Necro-Fantasy/STM32F103C8T6_BUCK_Converter/docs/BUCK-BOM.xlsx

位号 | 数量 | 名称 | 参数 | 型号/MPN | 封装 | 厂家/品牌
C6 | 1 | 铝电解电容 | 330uF | EEEFT1H331GP | SMD_10*10.3 | PANASONIC
C9 | 1 | 贴片电容 | 0.1uF | / | SMD_C0805 | Your Cee
U4 | 1 | 降压芯片 | 12V输入5V输出 | LM2596S-5.0 | TO-263-5 | UMW
D2 | 1 | 肖特基二极管 | 5A / 60V | SS56A | SMD_SS56A | FUXINSEMI
U3 | 1 | 功率电感 | 150uH | CDRH125L125NP-151MC | SMD_12*12 | Sumida
C7 | 1 | 铝电解电容 | 330uF | EEEFT1H331GP | SMD_10*10.3 | PANASONIC
C10 | 1 | 贴片电容 | 0.1uF | / | SMD_C0805 | Your Cee
SW1 | 1 | 按键开关 | / | XKB8080-Z | SW_TH-6P 8*8*2.5 | XKB Enterprise
R13 | 1 | 贴片电阻 | 5K | / | SMD_R0805 | ROYAL
LED4 | 1 | LED | / | 204-10SDRD | TH_LED3.0_Green | EVERLIGHT
OLED | 1 | OLED屏幕 | / | 0.96OLED_4P | TH_0.96OLED_4P | Your Cee
RLY1 | 1 | 继电器 | / | SRD-05VDC-SL-C | TH_RELAY | SONGLE
P1 | 1 | 直针座 | / | WJ500V-5.08-3P | TH_3Pin | KANGNEX
D1 | 1 | 二极管 | 100V / 150mA | 1N4148 | TH_DO-35 | STMicroelectronics
R7 | 1 | 贴片电阻 | 1K | / | SMD_R0805 | ROYAL
LED1 | 1 | LED | / | 204-10SDRD | TH_LED3.0_Red | EVERLIGHT
R8 | 1 | 贴片电阻 | 1K | / | SMD_R0805 | ROYAL
Q3 | 1 | 三极管 | / | S9013 | TO-92 | Your Cee
R14 | 1 | 贴片电阻 | 1K | / | SMD_R0805 | ROYAL
R15 | 1 | 贴片电阻 | 1K | / | SMD_R0805 | ROYAL
D6 | 1 | 二极管 | 1A/1000V | RS1M | SMD_SMA | Agertech
U5 | 1 | 驱动芯片 | / | IR2104STRPBF | SMD_SOCI-8 | IR
C12 | 1 | 独石电容 | 2.2uF | / | TH_5*2.5*5.08 | Your Cee
CN3 | 1 | 直针座 | / | XH-4A | TH-4Pin | HCTL
R33 | 1 | 贴片电阻 | 10K | / | SMD_R0805 | ROYAL
R31 | 1 | 贴片电阻 | 10K | / | SMD_R0805 | ROYAL
R34 | 1 | 贴片电阻 | 1K | / | SMD_R0805 | ROYAL
R32 | 1 | 贴片电阻 | 1K | / | SMD_R0805 | ROYAL
U18 | 1 | 电压采样芯片 | / | OPA2188 | SOP-8 | SOWO
C38 | 1 | 贴片电容 | 2.2uF | / | SMD_C0805 | Your Cee
C39 | 1 | 贴片电容 | 2.2uF | / | SMD_C0805 | Your Cee
D15 | 1 | 二极管 | 100V / 150mA | 1N4148 | TH_DO-35 | STMicroelectronics
R4 | 1 | 采样电阻 | 10mΩ | / | SMD_R1206 | ROYAL
R2 | 1 | 贴片电阻 | 9R1 | / | SMD_R0805 | ROYAL
R3 | 1 | 贴片电阻 | 9R1 | / | SMD_R0805 | ROYAL
C1 | 1 | 贴片电容 | 1nF | / | SMD_C0805 | Your Cee
U2 | 1 | 电流采样芯片 | / | INA213AIDCKR | TSSOP_6 | TI
C2 | 1 | 贴片电容 | 10nF | / | SMD_C0805 | Your Cee
C3 | 1 | 贴片电容 | 100nF | / | SMD_C0805 | Your Cee
D3 | 1 | 二极管 | 100V / 150mA | 1N4148 | TH_DO-35 | STMicroelectronics
CN1 | 1 | 直针座 | / | XH-4A | TH-4Pin | HCTL
U1 | 1 | 直针座 | / | KF7.62-2P | TH_2Pin | Cixi Kefa Elec
C8 | 1 | 贴片电容 | 100nF | / | SMD_C0805 | Your Cee
C14 | 1 | 电解电容 | 220uF | / | TH_ECAP_D10_P5 | CX
C13 | 1 | 电解电容 | 220uF | / | TH_ECAP_D10_P5 | CX
R5 | 1 | 贴片电阻 | 10k | / | SMD_R0805 | ROYAL
R6 | 1 | 贴片电阻 | 10 | / | SMD_R0805 | ROYAL
D5 | 1 | 二极管 | 100V / 150mA | 1N4148 | TH_DO-35 | STMicroelectronics
Q2 | 1 | NMOS | / | IRF3205ZPBF | TO-220-3 | Infineon
Q1 | 1 | NMOS | / | IRF3205ZPBF | TO-220-3 | Infineon
D4 | 1 | 二极管 | 100V / 150mA | 1N4148 | TH_DO-35 | STMicroelectronics
R10 | 1 | 贴片电阻 | 10 | / | SMD_R0805 | ROYAL
R11 | 1 | 贴片电阻 | 10k | / | SMD_R0805 | ROYAL
C4 | 1 | 电解电容 | 220uF | / | TH_ECAP_D10_P5 | CX
C11 | 1 | 电解电容 | 220uF | / | TH_ECAP_D10_P5 | CX
C5 | 1 | 贴片电容 | 100nF | / | SMD_C0805 | Your Cee
L1 | 1 | 功率电感 | 470uH | / | / | 滨江电子
R12 | 1 | 贴片电阻 | 0 | / | SMD_R0805 | ROYAL
U6 | 1 | 直针座 | / | KF7.62-2P | TH_2Pin | Cixi Kefa Elec
TP1 | 1 | M3铜柱 | / | / | / | Your Cee
TP2 | 1 | M3铜柱 | / | / | / | Your Cee
TP3 | 1 | M3铜柱 | / | / | / | Your Cee
TP4 | 1 | M3铜柱 | / | / | / | Your Cee
DEC1 | 1 | 按键 | / | / | SMD_6*6*5 | ReliaPro
ZENG1 | 1 | 按键 | / | / | SMD_6*6*6 | ReliaPro
FAN1 | 1 | 按键 | / | / | SMD_6*6*7 | ReliaPro
PAUSE1 | 1 | 按键 | / | / | SMD_6*6*8 | ReliaPro
DC1 | 1 | DC 电源插座 | DC-005 | DC-005-A-2.0 | TH_DC-005 | XKB Enterprise
