Necro-Fantasy/STM32F103C8T6_BUCK_Converter/docs/BUCK_Checklist.xlsx

Sheet: 00_统一测试标准
BUCK 项目统一测试标准
测试类别 | 适用阶段 | 允许工具 | 统一合格标准 | 禁止动作 | 备注
A. 外观检查 | 每个模块焊后 | 肉眼/手机放大/放大镜 | 无连锡、无虚焊、极性/方向与丝印一致 | 不确定方向时禁止上电 | IC、二极管、电解电容、排针方向优先检查
B. 断电短路检查 | 每个模块焊后、上电前 | 万用表蜂鸣档/电阻档 | 电源轨对地不持续短路；关键引脚之间不硬短 | 蜂鸣不查原因禁止上电 | 电容充电导致短叫一下可接受，持续蜂鸣不可接受
C. 低风险上电 | 断电检查通过后 | 可调电源/适配器 + 万用表 | 无冒烟、无异味、芯片不快速发热；电源不明显掉压 | 无真限流电源时禁止反复短路试错 | 若有实验电源，优先限流；无则短时上电并立即测电压
D. DC 电压检查 | 低风险上电后 | 万用表 | +5V: 4.80–5.20V；+3.3V: 3.20–3.40V；逻辑脚不应悬空到异常电压 | 电压异常时禁止插 STM32/禁止接负载 | 先看静态 DC，再看波形
E. 低速逻辑检查 | STM32 已插且程序可控后 | 万用表/示波器低速测 | IN、SD、EN 等逻辑电平与程序预期一致 | 未插 STM32 时禁止判断 IR2104 动态功能 | IR2104 的 HO/LO 需要有 IN/SD 才有判定意义
F. 示波器波形检查 | 接地弹簧到位后 | 示波器 x10 探头 + 短地弹簧 | 纹波/尖峰不超过模块标准；波形趋势符合拓扑 | 长地线测高速点后禁止据此判故障 | 没有接地弹簧时，只做慢速/低频判断
G. 功率测试 | 前级全部通过后 | 负载/电源/示波器/万用表 | 逐步升占空比/逐步加负载；无过热、无异常尖峰 | 禁止直接满占空比、禁止直接接大负载 | 主 Buck 最后做，先开环小占空比
备注 / 使用说明
这个工作簿不是公司级标准，而是适用于当前 STM32 + IR2104 + Buck 项目的个人工程标准。
门禁原则：没有通过断电检查，不上电；没有通过低压/静态检查，不插核心板；没有接地弹簧，不严肃判高速纹波/振铃；主功率级最后启动。

Sheet: 01_模块总览
BUCK 项目模块拆分总览
模块编号 | 模块名称 | 主要位号/器件 | 前置条件 | 本阶段目标 | 通过后允许进入 | 当前建议状态
M1 | 供电模块 LM2596 | DC1, SW1, C6, C9, U4, D2, U3, C7, C10, LED4/R13 | 无 | 确认 +12V 输入到 +5V 辅助电源稳定 | STM32 接口静态检查 | 已基本通过；纹波待接地弹簧补测
M2 | STM32 核心板接口 | H2/H3 排针/排母, +5V, +3.3V, GPIO/PWM/ADC/OLED 引脚 | M1 通过 | 确认插座供电、方向、关键 IO 不短路 | 插入 STM32，跑最小程序 | 未完成/待焊
M3 | IR2104 驱动模块 | U5, Cboot, VCC 去耦, D6, R5/R6/R10/R11, D4/D5 | M1 通过；M2 提供 IN/SD | 确认 VCC-COM、VB-VS、LO/HO 驱动逻辑 | 主功率 MOS 静态检查 | 已焊；当前只能做静态检查
M4 | 主功率半桥 | Q1/Q2, 栅极网络, 主功率输入电容/端子 | M3 静态通过；PWM/SD 可控 | 确认 MOS 栅极不误导通、半桥无直通 | 电感/输出滤波接入 | 未启动，禁止开主功率
M5 | 输出滤波与负载端 | 主电感、输出电容、输出端子 | M4 通过 | 确认输出 LC 滤波、空载输出、纹波 | 电压/电流采样联调 | 待完成
M6 | 电压/电流采样 | R4 采样电阻, INA213, OPA2188, ADC 分压/滤波 | M1/M2 通过；输出端可控 | 确认采样值与万用表一致 | 闭环控制/保护 | 待完成
M7 | 保护继电器/关断链路 | RLY1, D1, Q3, LED1, R7/R8/R14/R15, SD/保护信号 | M2/M3 通过 | 确认保护动作能关断输出 | 带保护的低功率测试 | 可先静态焊小件
M8 | 人机交互与显示 | OLED, KEY, SW, 编码器/按键接口 | M1/M2 通过 | 确认显示、按键、参数调节 | 系统联调 | 待完成

Sheet: 02_供电模块_LM2596
M1 供电模块 LM2596 Checklist
步骤ID | 阶段 | 检查项 | 操作 | 工具 | 统一合格标准 | 状态 | 实测值/记录 | 门禁结论 | 备注
M1-01 | 外观 | C6/C7 电解方向 | 核对丝印、负极标记和焊点 | 目视/照片放大 | 极性正确，无连锡/虚焊 | 已通过 | / | 禁止继续 | C6 输入侧，C7 输出侧
M1-02 | 外观 | D2 方向 | 确认 SS56A 阴极/阳极与原理图一致 | 目视/二极管档 | 方向正确；D2 为续流二极管 | 已通过 | / | 禁止继续 | D2 不是防反接，是关断续流
M1-03 | 断电 | +12V 对 DGND | 万用表蜂鸣/电阻测 +12V 到 DGND | 万用表 | 不持续短路 | 已通过 | 1.73V | 禁止继续 | 电容充电短叫可接受
M1-04 | 断电 | +5V 对 DGND | 万用表蜂鸣/电阻测 +5V 到 DGND | 万用表 | 不持续短路 | 已通过 | 1.64V | 禁止继续
M1-05 | 上电 | 12V 输入启动 | 短时上电观察 | 电源/万用表 | 不冒烟、不异味、不快速发热 | 已通过 | / | 禁止继续 | 无真限流电源时不要反复短路试错
M1-06 | DC | +5V 输出 | 测 +5V 到 DGND | 万用表 | 4.80–5.20V | 已通过 | 5.1V | 禁止继续
M1-07 | 启动 | 启动过冲 | Single 触发测 +5V 上升过程 | 示波器 | 无 >5.5V 有效过冲 | 已通过 |  | 禁止继续 | 已低通/限带判断通过
M1-08 | 纹波 | +5V 空载纹波 | 短地弹簧测 C7 两端 | 示波器 x10 | 目标 <50mVpp；<100mVpp 暂可接受 | 已通过 | Pk-Pk 84.19mV | 禁止继续
M1-09 | 热 | 空载 5 分钟 | 12V 空载运行 5 分钟 | 手感/测温 | 无明显发烫 | 已通过 | / | 禁止继续

Sheet: 03_STM32接口模块
M2 STM32 核心板接口 Checklist
步骤ID | 阶段 | 检查项 | 操作 | 工具 | 统一合格标准 | 状态 | 实测值/记录 | 门禁结论 | 备注
M2-01 | 外观 | STM32 排针/排母方向 | 确认排母位置、方向、焊点 | 目视/照片放大 | 方向正确，无连锡 | 已通过 | / | 禁止继续 | 核心板本体建议最后插
M2-02 | 断电 | +5V 对 DGND | 不插 STM32，测核心板座 +5V 到地 | 万用表 | 不持续短路 | 已通过 | 0.689V | 禁止继续
M2-03 | 断电 | +3.3V 对 DGND | 不插 STM32，测 +3.3V 到地 | 万用表 | 不持续短路 | 已通过 | 0.945V | 禁止继续 | 若 3.3V 由核心板提供，未插时可能无电
M2-04 | 上电 | 不插 STM32 测座子电压 | 只给主板上电，测 +5V/+3.3V 针脚 | 万用表 | +5V 4.80–5.20V；+3.3V 按供电来源判断 | 已通过 | 4.96V/3.27V | 禁止继续 | 无异常再插核心板
M2-05 | 上电 | 插 STM32 后供电 | 插核心板，短时上电 | 万用表 | 3.3V: 3.20–3.40V；芯片不发热 | 已通过 | 3.27V | 禁止继续 | 异常立即断电
M2-06 | 功能 | 最小程序运行 | 跑 LED/OLED/串口等低风险程序 | STM32/万用表 | 不复位、不死机 | 已通过 | / | 禁止继续 | 先不要输出 PWM 到功率级
M2-07 | 逻辑 | PWM/SD GPIO 静态电平 | 程序控制 IN/SD 输出高低电平 | 万用表/示波器 | 电平与程序一致 | 已通过 | IN3.26V,SD0.06V | 禁止继续 | 先空载测逻辑，不接主功率

Sheet: 04_IR2104驱动模块
M3 IR2104 驱动模块 Checklist
步骤ID | 阶段 | 检查项 | 操作 | 工具 | 统一合格标准 | 状态 | 实测值/记录 | 门禁结论 | 备注
M3-01 | 外观 | IR2104 方向 | 确认 U5 1脚方向、SOIC-8 焊点 | 目视/照片放大 | 方向正确，无连锡 | 已通过 | / | 禁止继续 | 已焊但需复查
M3-02 | 外观 | 自举二极管 D6 方向 | 核对 D6 阳极/阴极网络 | 目视/二极管档 | VCC → D6 → VB 方向正确 | 已通过 | 0.582V | 禁止继续 | D6 型号字段曾有不一致，需确认
M3-03 | 外观 | 自举电容位置 | 核对电容接在 VB-VS | 目视/万用表 | 一端 VB，一端 VS | 已通过 | / | 禁止继续 | 不是 VCC-VS
M3-04 | 断电 | VCC-COM | 测 IR2104 VCC 到 COM | 万用表 | 不持续短路 | 已通过 | 0.49V | 禁止继续
M3-05 | 断电 | VB-VS | 测 VB 到 VS | 万用表 | 不持续短路 | 已通过 | 0.582V | 禁止继续
M3-06 | 断电 | HO-VS | 测 HO 到 VS | 万用表 | 不硬短 | 已通过 | 0.615V | 禁止继续
M3-07 | 断电 | LO-COM | 测 LO 到 COM | 万用表 | 不硬短 | 已通过 | OL | 禁止继续
M3-08 | DC | VCC-COM 供电 | 上电测 IR2104 VCC | 万用表 | 按设计驱动供电，通常 10–20V | 已通过 | 11.77V | 禁止继续 | 若板上未给驱动电源，先不要判功能
M3-09 | 逻辑 | IN/SD 输入 | STM32 程序输出静态高低电平 | 万用表/示波器 | 与程序一致；SD 可关断 | 已通过 | IN3.26V,SD0.06V | 禁止继续 | 未插 STM32 前不测动态
M3-10 | 波形 | LO-COM 波形 | 先测低边驱动输出 | 示波器短地 | 幅值与 VCC 接近，频率/占空比正确 | 已通过 | / | 禁止继续 | 接地弹簧到位后测
M3-11 | 波形 | VB-VS / HO-VS | 建立自举后测高边驱动 | 示波器差分思路/短地 | VB-VS 维持正常；HO-VS 能驱动 MOS | 已通过 | / | 禁止继续 | 不要只看 HO 对地

Sheet: 05_主功率半桥模块
M4 主功率半桥模块 Checklist
步骤ID | 阶段 | 检查项 | 操作 | 工具 | 统一合格标准 | 状态 | 实测值/记录 | 门禁结论 | 备注
M4-01 | 外观 | Q1/Q2 方向与引脚 | 核对 G/D/S 与 PCB 丝印 | 目视/数据手册 | 方向正确，无错脚 | 已通过 | / | 禁止继续 | TO-220 引脚必须核对
M4-02 | 外观 | R5/R6/R10/R11/D4/D5 栅极网络 | 核对阻值、二极管方向、焊点 | 万用表/目视 | 阻值正确、D4/D5 方向正确 | 已通过 | / | 禁止继续 | D5/D4 用于栅极充放电速度控制
M4-03 | 断电 | 上管/下管 D-S 短路 | 测 MOS D-S 之间 | 万用表 | 不应硬短 | 已通过 | 1.906V | 禁止继续 | 体二极管方向读数需区分
M4-04 | 断电 | Gate 对 Source | 测 G-S 是否短路 | 万用表 | 不硬短；下拉电阻阻值合理 | 已通过 | 1.847V | 禁止继续
M4-05 | 逻辑 | 不开主电源只测 Gate | 只给驱动/MCU，确认 Gate 不误导通 | 示波器/万用表 | SD 关断时 HO/LO 均关闭 | 已通过 | / | 禁止继续 | 先不接负载
M4-06 | 功率前门禁 | 半桥直通风险 | 确认死区、SD、栅极下拉、驱动逻辑 | 示波器 | 上下管不得同时导通 | 已通过 | / | 禁止继续 | 没通过前禁止开主功率
M4-07 | 低功率 | 小占空比开环 | 低输入/小占空比/空载试运行 | 示波器/万用表 | 无异常发热、无电源掉压 | 未开始 |  | 待补充 | 逐步推进，不直接满占空比

Sheet: 06_输出滤波负载模块
M5 输出滤波与负载端 Checklist
步骤ID | 阶段 | 检查项 | 操作 | 工具 | 统一合格标准 | 状态 | 实测值/记录 | 门禁结论 | 备注
M5-01 | 外观 | 主电感/输出电容焊接 | 核对参数、极性、焊点 | 目视/万用表 | 电感焊牢，电解极性正确 | 已通过 | / | 待补充 | 大件可能挡焊接，按顺序最后焊
M5-02 | 断电 | 输出端对地 | 测 Vout 到 DGND | 万用表 | 不持续短路 | 已通过 | 0.97V | 待补充 | 输出电容充电短叫可接受
M5-03 | 空载 | 输出电压开环小占空比 | 空载低占空比启动 | 万用表/示波器 | 输出随占空比变化，无异常尖峰 | 未开始 |  | 待补充 | 未闭环前不要追求目标电压
M5-04 | 纹波 | 输出纹波 | 短地弹簧测输出电容两端 | 示波器 | 按目标暂定 <100mVpp 小功率可接受 | 未开始 |  | 待补充 | 长地线不判定
M5-05 | 负载 | 轻载测试 | 接小负载逐步增加 | 万用表/示波器 | 电压稳定，器件不过热 | 未开始 |  | 待补充 | 无电子负载时先谨慎

Sheet: 07_采样模块
M6 电压/电流采样模块 Checklist
步骤ID | 阶段 | 检查项 | 操作 | 工具 | 统一合格标准 | 状态 | 实测值/记录 | 门禁结论 | 备注
M6-01 | 外观 | R4 采样电阻 | 确认阻值/封装/焊接 | 万用表/目视 | 10mΩ 级采样电阻，焊点可靠 | 未开始 |  | 待补充 | 低阻值普通表不一定准
M6-02 | 外观 | INA213/OPA2188 方向 | 核对芯片方向和周边阻容 | 目视/照片放大 | 方向正确，无连锡 | 已通过 | / | 待补充 | U18 字段曾需确认
M6-03 | 断电 | 采样输入对地 | 测采样信号是否短地/短电源 | 万用表 | 不硬短 | 已通过 | VOUT:1.84V/GND:0.654V | 待补充
M6-04 | DC | ADC 输入范围 | 上电测 ADC 输入静态电压 | 万用表 | 0–3.3V 范围内，不超 MCU 允许值 | 未开始 |  | 待补充 | 超过 3.3V 禁止接 STM32 ADC
M6-05 | 校准 | 电压采样对比 | 万用表测 Vout，对比 ADC/OLED 显示 | 万用表/串口/OLED | 误差可解释，可软件校准 | 未开始 |  | 待补充
M6-06 | 校准 | 电流采样对比 | 串联电流表或已知负载对比 | 万用表/负载 | 趋势正确，零点偏置可校正 | 未开始 |  | 待补充

Sheet: 08_保护继电器模块
M7 保护继电器 / 关断链路 Checklist
步骤ID | 阶段 | 检查项 | 操作 | 工具 | 统一合格标准 | 状态 | 实测值/记录 | 门禁结论 | 备注
M7-01 | 外观 | 继电器小件 | 先焊 R7/R8/D1/LED1/Q3 等小件 | 目视/万用表 | 阻值正确，D1/LED 方向正确 | 已通过 | / | 待补充 | 继电器本体可后焊
M7-02 | 断电 | +5V 对地 | 焊小件后复测 +5V 对地 | 万用表 | 不持续短路 | 已通过 | 1.597V | 待补充
M7-03 | DC | Q3 控制脚 | STM32 控制保护脚高低电平 | 万用表 | 电平与程序一致 | 未开始 |  | 待补充
M7-04 | 功能 | 继电器动作 | 焊继电器后测试吸合/释放 | 万用表/听音 | 动作明确，无异常发热 | 未开始 |  | 待补充 | 先低风险测试线圈，不接主功率
M7-05 | 保护 | 故障关断链路 | 模拟过压/过流/按键复位 | 万用表/示波器 | 故障时 PWM/SD/继电器按预期关断 | 未开始 |  | 待补充 | 这是系统级测试

Sheet: 99_下拉选项
状态选项 | 门禁选项
未开始 | 可以继续
已通过 | 禁止继续
待测 | 待补充
暂停 | 不适用
失败
不适用

Sheet: 09_UI人机交互模块
M8 OLED / 按键 / UI 模块 Checklist
步骤ID | 阶段 | 检查项 | 操作 | 工具 | 统一合格标准 | 状态 | 实测值/记录 | 门禁结论 | 备注
M8-01 | 外观 | OLED/按键/编码器接口 | 核对排针方向、焊点 | 目视/万用表 | 无连锡，方向正确 | 未开始 |  | 待补充
M8-02 | 断电 | 接口电源对地 | 测 +3.3V/+5V 到地 | 万用表 | 不持续短路 | 未开始 |  | 待补充
M8-03 | 功能 | OLED 显示 | 运行显示程序 | STM32/OLED | 显示稳定、不花屏 | 未开始 |  | 待补充
M8-04 | 功能 | 按键/编码器 | 读取输入状态 | 串口/OLED | 按键动作与状态一致 | 未开始 |  | 待补充
M8-05 | 系统 | UI 调参 | 调目标电压/模式/故障复位 | OLED/按键 | 状态机不乱跳，参数可控 | 未开始 |  | 待补充 | 先软件仿真/空载，再接功率
