Necro-Fantasy/STM32F103C8T6_BUCK_Converter/docs/Debug_Log_EN.docx

2026/7/27

Problem: After power-up with no load, the ADC current reading was abnormal.

Troubleshooting:

1. Checked the ADC conversion logic in software; the calculation flow was correct.

2. Suspected the fault was in the current-sensing circuit.

3. Measured the INA213 pins and found an abnormally low resistance (continuity beep) near the chip's V+ and GND pins.

4. However, the voltage across C2/C3 and the +5V-to-DGND rail were normal, so this was not a hard short between +5V and DGND on the whole board.

5. Initial suspicion: a cold solder joint on an INA213 pin, a local soldering defect, or a damaged chip.

6. Reworked the INA213 solder joints; the problem remained.

7. Replaced the INA213; the ADC current reading returned to normal.

Conclusion:

The INA213 was damaged. A cold joint or local soldering defect was an intermediate hypothesis, but replacing the chip confirmed a fault in the chip itself.

Resolution:

Replaced the INA213; problem solved.

2026/7/30

Problem: After power-up the firmware entered the READY/RUN state, but LED1 did not light and the relay indicator branch behaved abnormally.

Troubleshooting:

1. Measured the +5V pads for the relay and D1; supply was normal.

2. Measured an abnormal voltage at the nominal +5V end of R7: the solder/component side read about -2.1 V to DGND, suggesting the node was floating or poorly connected.

3. In multimeter continuity mode, probing R7's +5V pad beeped normally, but probing the solder/component side of R7 did not.

4. During the continuity test LED1 could be lit, indicating that LED1, the downstream circuit and the Q3 low-side path were most likely fine.

5. Because the pad was connected to the +5V net but the component/solder was not reliably connected to the pad, concluded that the +5V end of R7 had a cold solder joint.

Conclusion:

A cold solder joint at the +5V end of R7 left the LED1 indicator branch without a stable supply.

Resolution:

Reworked R7 locally with a fine-tip iron and flux. After power-up the board entered RUN and LED1 lit normally; problem solved.

2026/8/3

Problem: The ADC reading was not zero at no load.

Troubleshooting:

1. Measured the voltage on the ADC input pin PA0.
2. Found that the pin voltage was not zero while the ADC conversion itself was correct, so a software offset compensation was needed.

Conclusion:

A residual voltage on the pin made the ADC reading inaccurate; the displayed voltage was about 0.44–0.45 V higher than the actual voltage.

Resolution:

Added a compensation parameter to remove the zero offset, and re-verified the offset error and gain error.

2026/8/5

VSCode debug reported "could not connect / error 138", although MDK could flash the board and the .elf was generated. The log also showed: "Failure starting GDB server: TCP port 61234 not available" => not a hardware problem and not a code problem => leftover GDB server / GDB / ST-LINK processes from the previous session were holding the debug port => fixed by running taskkill as administrator, or by restarting the computer.

2026/8/10

Problem: After the board entered the RUN state, the ADC voltage reading was abnormal, and VOUT showed about 3.27 V even with the buck power input VIN disconnected.

Troubleshooting:

1. Checked the software logic (ADC conversion, TIM1 interrupt, Buck_IsControlEnabled(), Timer_SetPwmCompareValue(), etc.); no obvious problem found.
2. Tested all four combinations (00, 01, 10, 11) of the BuckRunning and ControlEnabled flags; the fault depended on ControlEnabled and was largely unaffected by BuckRunning.
3. After confirming the software was correct, shifted the investigation from software to hardware.
4. With buck VIN disconnected, measured VOUT ≈ 3.27 V; the voltage barely changed with a 6 kΩ load attached, showing a real energy source at the output rather than a phantom voltage on the multimeter.
5. Disabling the IR2104 made the abnormal VOUT disappear, narrowing the fault to the IR2104, the MOSFETs and the half-bridge drive circuit.
6. Compared the high-side MOSFET G-S resistance between the old and new boards: about 9.6 kΩ on the old board versus only 35–46 Ω on the new one, so the high-side MOSFET or HO drive path was suspected first.
7. After removing the high-side MOSFET, the device itself measured OL between G and S, but the Gate-Source pads on the PCB still showed about 35 Ω, ruling out the MOSFET itself.
8. Compared the IR2104 next: on the new board HO-VS was about 35 Ω and LO-COM was low-resistance (beeping), versus about 350 Ω and OL on the old board, so the IR2104 or its solder area was suspected.
9. After removing the IR2104, the abnormal low resistance on HO-VS and LO-COM disappeared from the PCB. After replacing and resoldering the IR2104, HO-VS read about 1.6 kΩ and LO-COM about 15 MΩ, so the static resistance fault was gone. However, the ADC/VOUT fault in the RUN state remained, indicating a second fault.
10. Checked the bootstrap circuit: the bootstrap diode forward drop was about 0.5 V and VB to ground was about 11.8 V, but VB-VS across C12 was only about 8.3 V, so the VS node was examined next.
11. On the oscilloscope, LO switched normally between 0 and 12 V, but VS only fell to about 3–3.5 V instead of being pulled close to 0 V by the low-side MOSFET, narrowing the fault to the low-side MOSFET drive chain.
12. Forced PWM_IN (PA8) to 0 in software while keeping the IR2104 enabled, holding LO high. Measured LO ≈ 12 V but Q1 VGS ≈ 0 V: the IR2104 output was correct, but the drive voltage was not reaching the low-side MOSFET gate.
13. Measured node by node along LO → R10 → Q1 gate and finally found a cold solder joint on R10. Although continuity mode showed the PCB connection from R10 to the gate as normal, the drive voltage could not pass through R10 under real operating conditions.
14. After reworking R10, Q1 gate drive was restored, VS could be pulled low normally, and the ADC reading and VOUT returned to normal.

Conclusion:

This failure involved two independent problems:

1. The original IR2104 or its solder area was abnormal, shown by clearly abnormal static resistance on HO-VS and LO-COM; replacing/resoldering the IR2104 removed it. It cannot be fully confirmed whether the IR2104 chip itself was damaged or the original soldering was the cause.
2. The cold solder joint on R10 was the confirmed cause of the main malfunction in the RUN state. It prevented low-side MOSFET Q1 from getting a proper VGS, so Q1 could not turn on and VS could not be pulled low, which in turn disrupted the half bridge, the bootstrap circuit, VOUT and the ADC readings.

Resolution:

Replacing/resoldering the IR2104 removed the abnormal static resistance in the driver area. Reworking R10 restored the low-side MOSFET drive, the VS node, VOUT and the ADC readings; fault resolved.

2026/8/19

Problem: After moving key scanning from the original TIM1 1 ms scheduling chain into the FreeRTOS inputTask, the keys stopped responding and CurrentState stayed at APP_OFF.

Troubleshooting:

1. Confirmed that inputTask was running: set a breakpoint at Key_Scan1ms(); and verified that inputTask was created and scheduled by the scheduler. No issue.
2. Checked whether key scanning actually produced events by watching PendingKeyEvent in the Expressions window. No issue.
3. Checked the event consumer chain: confirmed in the debugger that PendingKeyEvent and KeyEvent were correct and that events were read correctly by Key_GetEvent(). No issue.
4. Inspected StartInputTask() and found the problem in the osDelay call.

Conclusion:

Moving from an ISR to a task changed the call period of the key-scan function, breaking the 1 ms timing assumption implicit in the original code. The software module relied on an unwritten timing contract, and the RTOS migration broke it.

Resolution:

Changed osDelay(50); to osDelay(1);
