Necro-Fantasy/STM32F103C8T6_BUCK_Converter/Firmware/Core/Src/main.c

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
/* Includes ------------------------------------------------------------------*/
#include "main.h"
#include "cmsis_os.h"
#include "adc.h"
#include "dma.h"
#include "tim.h"
#include "gpio.h"

/* USER CODE BEGIN Includes */
#include "power_stage.h"
#include "adc_sample.h"
#include "buck_pwm.h"
#include "buck_control.h"
#include "measurement.h"
#include "protection.h"
#include "key.h"
#include "app_state.h"
#include "oled.h"
#include "ui.h"
#include "FreeRTOS.h"
#include "app_freertos.h"
/* USER CODE END Includes */

/* USER CODE BEGIN PD */
#define BUCK_CONTROL_UPDATE_DIVIDER    20u
/* USER CODE END PD */


void SystemClock_Config(void);
void MX_FREERTOS_Init(void);
/**
  * @brief  The application entry point.
  * @retval int
  */
int main(void)
{

  /* MCU Configuration--------------------------------------------------------*/

  /* Reset of all peripherals, Initializes the Flash interface and the Systick. */
  HAL_Init();

  /* Configure the system clock */
  SystemClock_Config();

  /* Initialize all configured peripherals */
  MX_GPIO_Init();
  MX_DMA_Init();
  MX_ADC1_Init();
  MX_TIM1_Init();
  /* USER CODE BEGIN 2 */
  PowerStage_Init();
  ADC_Sample_Init();
  Measurement_Init();
  BuckPwm_Init();
  BuckControl_Init();
  Key_Init();
  AppState_Init();

  UI_Init();

  HAL_TIM_Base_Start_IT(&htim1);/* 真正开启 TIM1 Update Interrupt */
  /* USER CODE END 2 */

  /* Init scheduler */
  osKernelInitialize();  /* Call init function for freertos objects (in cmsis_os2.c) */
  MX_FREERTOS_Init();

  /* Start scheduler */
  osKernelStart();

  /* We should never get here as control is now taken by the scheduler */

  /* Infinite loop */
  /* USER CODE BEGIN WHILE */
  while (1)
  {
    /* USER CODE END WHILE */

    /* USER CODE BEGIN 3 */
  }
  /* USER CODE END 3 */
}

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
/* USER CODE BEGIN 4 */
void HAL_ADC_ErrorCallback(ADC_HandleTypeDef *hadc)
{
    if(hadc->Instance == ADC1)
    {
        BuckControl_LatchFault();
    }
}
/* USER CODE END 4 */

/**
  * @brief  Period elapsed callback in non blocking mode
  * @note   This function is called  when TIM4 interrupt took place, inside
  * HAL_TIM_IRQHandler(). It makes a direct call to HAL_IncTick() to increment
  * a global variable "uwTick" used as application time base.
  * @param  htim : TIM handle
  * @retval None
  */
void HAL_TIM_PeriodElapsedCallback(TIM_HandleTypeDef *htim)
{
  /* USER CODE BEGIN Callback 0 */
  uint16_t ADCVoltageRawValue;
  uint16_t ADCCurrentRawValue;

  ADCVoltageRawValue = ADC_Sample_GetVoltageRaw();
  ADCCurrentRawValue = ADC_Sample_GetCurrentRaw();
  static uint8_t TIM1UpdateCount = 0u;


  if(htim->Instance == TIM1)
  {
      TIM1UpdateCount++;

      if(TIM1UpdateCount >= BUCK_CONTROL_UPDATE_DIVIDER)
      {
          TIM1UpdateCount = 0u;


          if(AppState_Get() == APP_RUN)
          {
              if(Protection_IsFaultDetected(
                      ADCVoltageRawValue,
                      ADCCurrentRawValue) != 0u)
              {
            	  BuckControl_LatchFault();
              }
              else
              {
            	  ControlTask_NotifyFromISR();
              }
          }
      }
  }

  /* USER CODE END Callback 0 */
  if (htim->Instance == TIM4)
  {
    HAL_IncTick();
  }
}

/**
  * @brief  This function is executed in case of error occurrence.
  * @retval None
  */
void Error_Handler(void)
{
  /* USER CODE BEGIN Error_Handler_Debug */
  /* User can add his own implementation to report the HAL error return state */
  __disable_irq();
  while (1)
  {
  }
  /* USER CODE END Error_Handler_Debug */
}
#ifdef USE_FULL_ASSERT
/**
  * @brief  Reports the name of the source file and the source line number
  *         where the assert_param error has occurred.
  * @param  file: pointer to the source file name
  * @param  line: assert_param error line source number
  * @retval None
  */
void assert_failed(uint8_t *file, uint32_t line)
{
  /* USER CODE BEGIN 6 */
  /* User can add his own implementation to report the file name and line number,
     ex: printf("Wrong parameters value: file %s on line %d\r\n", file, line) */
  /* USER CODE END 6 */
}
#endif /* USE_FULL_ASSERT */
