Necro-Fantasy/STM32F103C8T6_BUCK_Converter/Firmware/Core/Inc/main.h

#define VOLTAGE_Pin GPIO_PIN_0
#define VOLTAGE_GPIO_Port GPIOA
#define CURRENT_Pin GPIO_PIN_1
#define CURRENT_GPIO_Port GPIOA
#define OLED_SDA_Pin GPIO_PIN_0
#define OLED_SDA_GPIO_Port GPIOB
#define OLED_SCL_Pin GPIO_PIN_1
#define OLED_SCL_GPIO_Port GPIOB
#define KEY_ADD_Pin GPIO_PIN_12
#define KEY_ADD_GPIO_Port GPIOB
#define KEY_REDUCE_Pin GPIO_PIN_13
#define KEY_REDUCE_GPIO_Port GPIOB
#define KEY_SET_Pin GPIO_PIN_14
#define KEY_SET_GPIO_Port GPIOB
#define KEY_MODE_Pin GPIO_PIN_15
#define KEY_MODE_GPIO_Port GPIOB
#define PWM_IN_Pin GPIO_PIN_8
#define PWM_IN_GPIO_Port GPIOA
#define PWM_SD_Pin GPIO_PIN_9
#define PWM_SD_GPIO_Port GPIOA
#define PROTECT_Pin GPIO_PIN_10
#define PROTECT_GPIO_Port GPIOA
