Necro-Fantasy/STM32F103C8T6_BUCK_Converter/Firmware/Core/Inc/oledfont.h

#ifndef __OLEDFONT_H

#define __OLEDFONT_H

// Common ASCII table.

// Offset: 32.

// ASCII character set.

// Offset: 32.

// Size: 12 x 6.

/************************************ 6 x 8 dot matrix ************************************/

const unsigned char F6x8[] =

{

0x00, 0x00, 0x00, 0x00, 0x00, 0x00,// sp

0x00, 0x00, 0x00, 0x2f, 0x00, 0x00,// !

0x00, 0x00, 0x07, 0x00, 0x07, 0x00,// "

0x00, 0x14, 0x7f, 0x14, 0x7f, 0x14,// #

0x00, 0x24, 0x2a, 0x7f, 0x2a, 0x12,// $

0x00, 0x62, 0x64, 0x08, 0x13, 0x23,// %

0x00, 0x36, 0x49, 0x55, 0x22, 0x50,// &

0x00, 0x00, 0x05, 0x03, 0x00, 0x00,// '

0x00, 0x00, 0x1c, 0x22, 0x41, 0x00,// (

0x00, 0x00, 0x41, 0x22, 0x1c, 0x00,// )

0x00, 0x14, 0x08, 0x3E, 0x08, 0x14,// *

0x00, 0x08, 0x08, 0x3E, 0x08, 0x08,// +

0x00, 0x00, 0x00, 0xA0, 0x60, 0x00,// ,

0x00, 0x08, 0x08, 0x08, 0x08, 0x08,// -

0x00, 0x00, 0x60, 0x60, 0x00, 0x00,// .

0x00, 0x20, 0x10, 0x08, 0x04, 0x02,// /

0x00, 0x3E, 0x51, 0x49, 0x45, 0x3E,// 0

0x00, 0x00, 0x42, 0x7F, 0x40, 0x00,// 1

0x00, 0x42, 0x61, 0x51, 0x49, 0x46,// 2

0x00, 0x21, 0x41, 0x45, 0x4B, 0x31,// 3

0x00, 0x18, 0x14, 0x12, 0x7F, 0x10,// 4

0x00, 0x27, 0x45, 0x45, 0x45, 0x39,// 5

0x00, 0x3C, 0x4A, 0x49, 0x49, 0x30,// 6

0x00, 0x01, 0x71, 0x09, 0x05, 0x03,// 7

0x00, 0x36, 0x49, 0x49, 0x49, 0x36,// 8

0x00, 0x06, 0x49, 0x49, 0x29, 0x1E,// 9

0x00, 0x00, 0x36, 0x36, 0x00, 0x00,// :

0x00, 0x00, 0x56, 0x36, 0x00, 0x00,// ;

0x00, 0x08, 0x14, 0x22, 0x41, 0x00,// <

0x00, 0x14, 0x14, 0x14, 0x14, 0x14,// =
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

{0x00,0x08,0x30,0x00,0xFF,0x20,0x20,0x20,0x20,0xFF,0x20,0x20,0x22,0x2C,0x20,0x00},

{0x04,0x04,0x02,0x01,0xFF,0x80,0x40,0x30,0x0E,0x01,0x06,0x18,0x20,0x40,0x80,0x00},/* State glyph 9 */

{0x00,0x04,0x84,0x84,0x44,0x24,0x54,0x8F,0x14,0x24,0x44,0x84,0x84,0x04,0x00,0x00},

{0x41,0x39,0x00,0x00,0x3C,0x40,0x40,0x42,0x4C,0x40,0x40,0x70,0x04,0x09,0x31,0x00},/* State glyph 10 */

{0x80,0x82,0x82,0x82,0xFE,0x82,0x82,0x82,0x82,0x82,0xFE,0x82,0x82,0x82,0x80,0x00},

{0x00,0x80,0x40,0x30,0x0F,0x00,0x00,0x00,0x00,0x00,0xFF,0x00,0x00,0x00,0x00,0x00},/* On glyph 11 */

{0x00,0x00,0x00,0xFC,0x44,0x44,0x44,0x45,0x46,0x44,0x44,0x44,0x44,0x7C,0x00,0x00},

{0x40,0x20,0x18,0x07,0x00,0xFC,0x44,0x44,0x44,0x44,0x44,0x44,0x44,0xFC,0x00,0x00},/* On glyph 12 */

{0x00,0x00,0x10,0x11,0x16,0x10,0x10,0xF0,0x10,0x10,0x14,0x13,0x10,0x00,0x00,0x00},

{0x81,0x81,0x41,0x41,0x21,0x11,0x0D,0x03,0x0D,0x11,0x21,0x41,0x41,0x81,0x81,0x00},/* Off glyph 13 */

{0x00,0xF8,0x01,0x22,0x20,0x22,0x22,0xA2,0xFA,0x22,0x22,0x22,0x02,0xFE,0x00,0x00},

{0x00,0xFF,0x00,0x08,0x04,0x02,0x11,0x20,0x1F,0x00,0x00,0x40,0x80,0x7F,0x00,0x00},/* Off glyph 14 */



















};



#endif
