Necro-Fantasy/STM32F103C8T6_BUCK_Converter/Firmware/Core/Inc/power_stage.h

#ifndef __POWER_STAGE_H
#define __POWER_STAGE_H

#include "main.h"

void PowerStage_Init(void);

void PowerStage_DriverOn(void);
void PowerStage_DriverOff(void);

void PowerStage_ProtectionOn(void);
void PowerStage_ProtectionOff(void);


#endif
