Necro-Fantasy/STM32F103C8T6_BUCK_Converter/(notices)

Notices in the files:
Firmware/Core/Src/main.c:
Copyright (c) 2026 STMicroelectronics.
All rights reserved.
This software is licensed under terms that can be found in the LICENSE file
